jrmfrbg/7SegmentWattageCounterESP32/Altium_Data/high-24145_1280.png

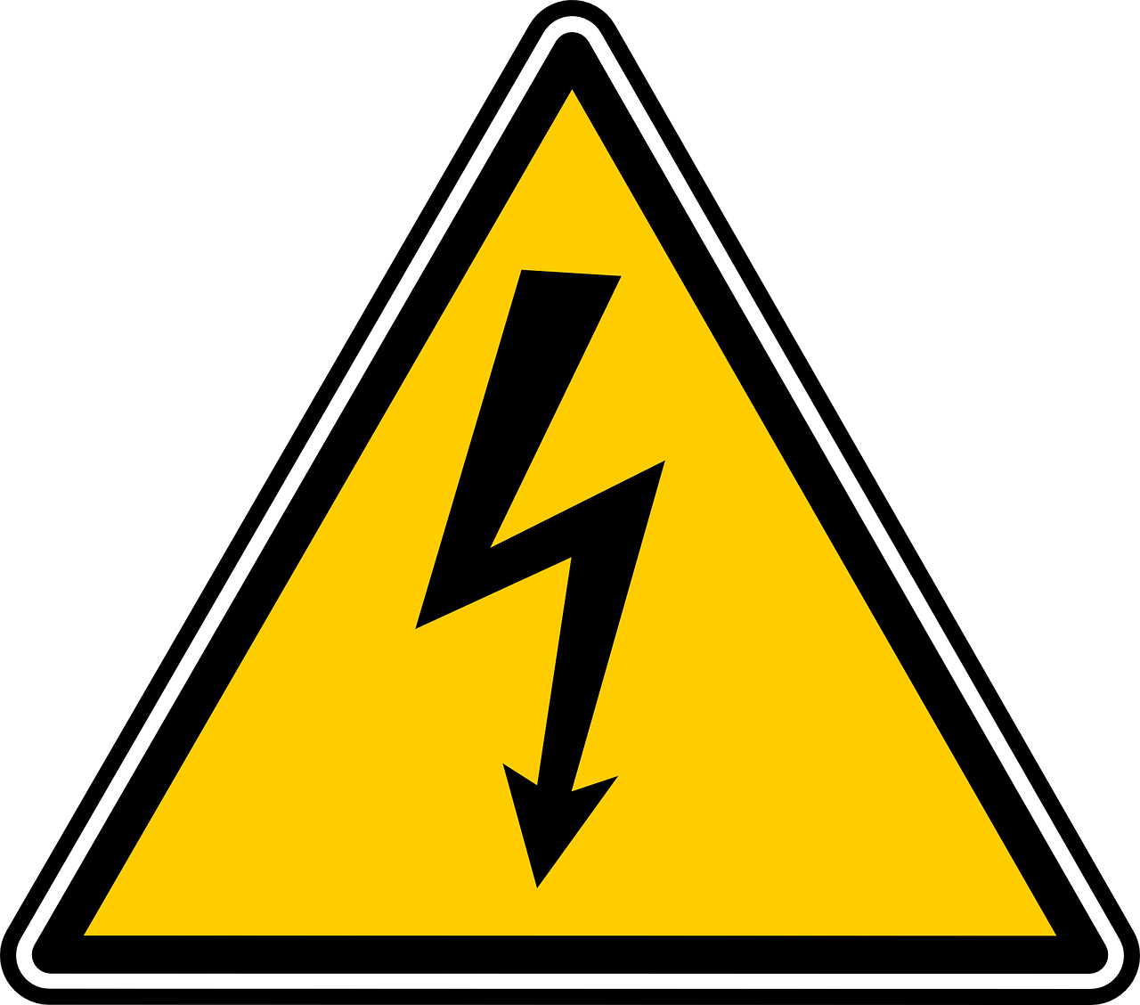
Altium_Data/high-24145_1280.png
