jrmfrbg/7SegmentWattageCounterESP32/Altium_Data/muempel8.bmp

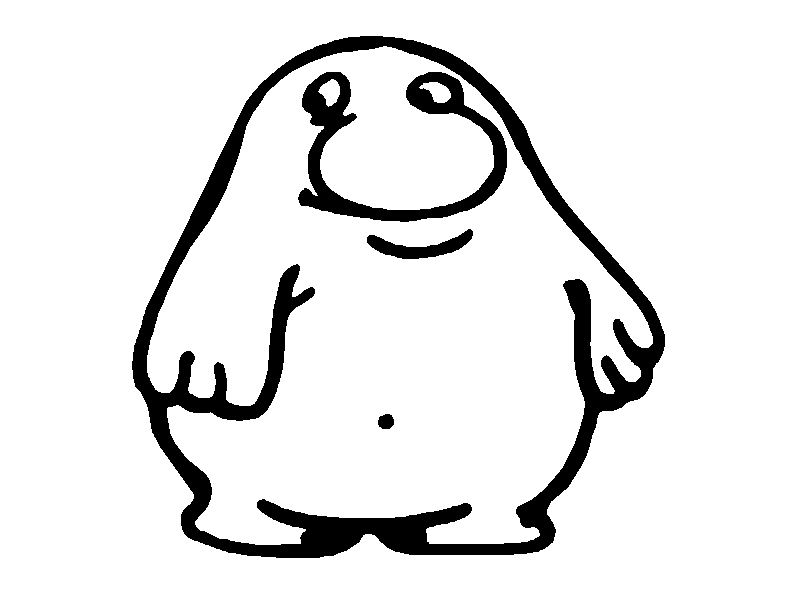
Altium_Data/muempel8.bmp
