jrmfrbg/7SegmentWattageCounterESP32/Altium_Data/Project Outputs for AC-Power-Monitor/AC-Power-Monitor.pdf

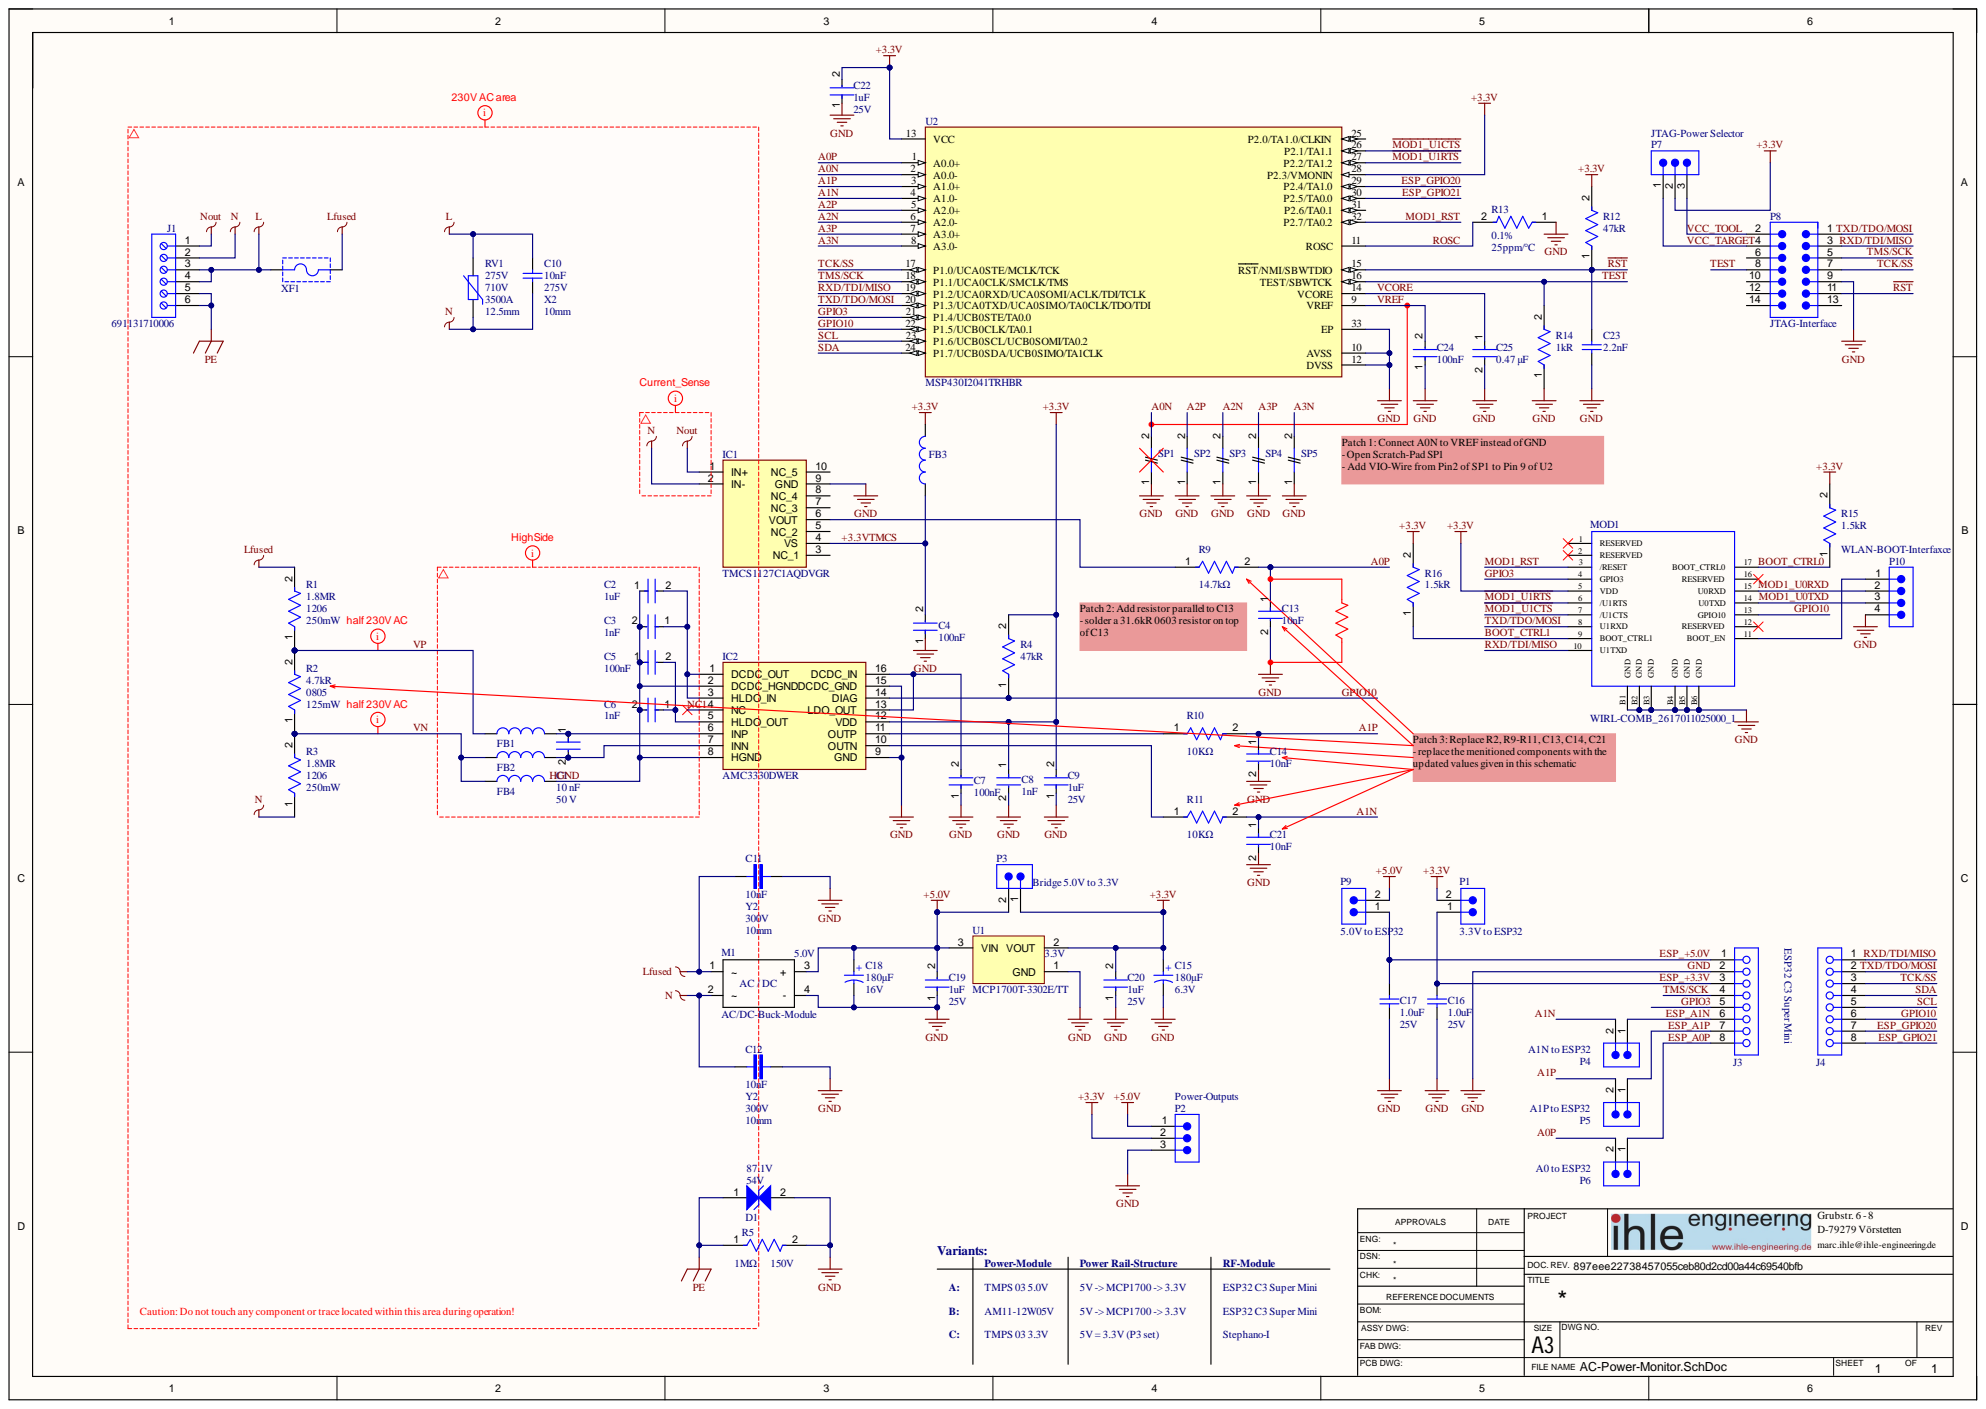
[picture p3: page 1]

Patch 1:Connect A0N to VREF instead ofGND
-Open Scratch-Pad SP1
- Add VIO-Wire from Pin2 of SP1 to Pin 9 of U2

+3.3VTMCS

MOD1_RST | RESERVED 2

Patch 2:Add resistor parallel to C13
-solder a 31.6kR 0603 resistor on top
ofC13

Patch 3:ReplaceR2, R9-R11, C13, C14, C21
-replace themenitioned components with the
updated values given in thisschematic

GND | 2
ESP_+3.3V | 3

TMS/SCK A1N | 4

AC/DC-Buck-Module

ESP_A1P | 7
ESP_A0P | 8

DATE | PROJECT APPROVALS | Grubstr. 6 - 8 D-79279 Vörstetten marc.ihle@ihle-engineering.de

ENG: *

DSN: *

Caution:Do not touch any component or trace located within this area during operation!

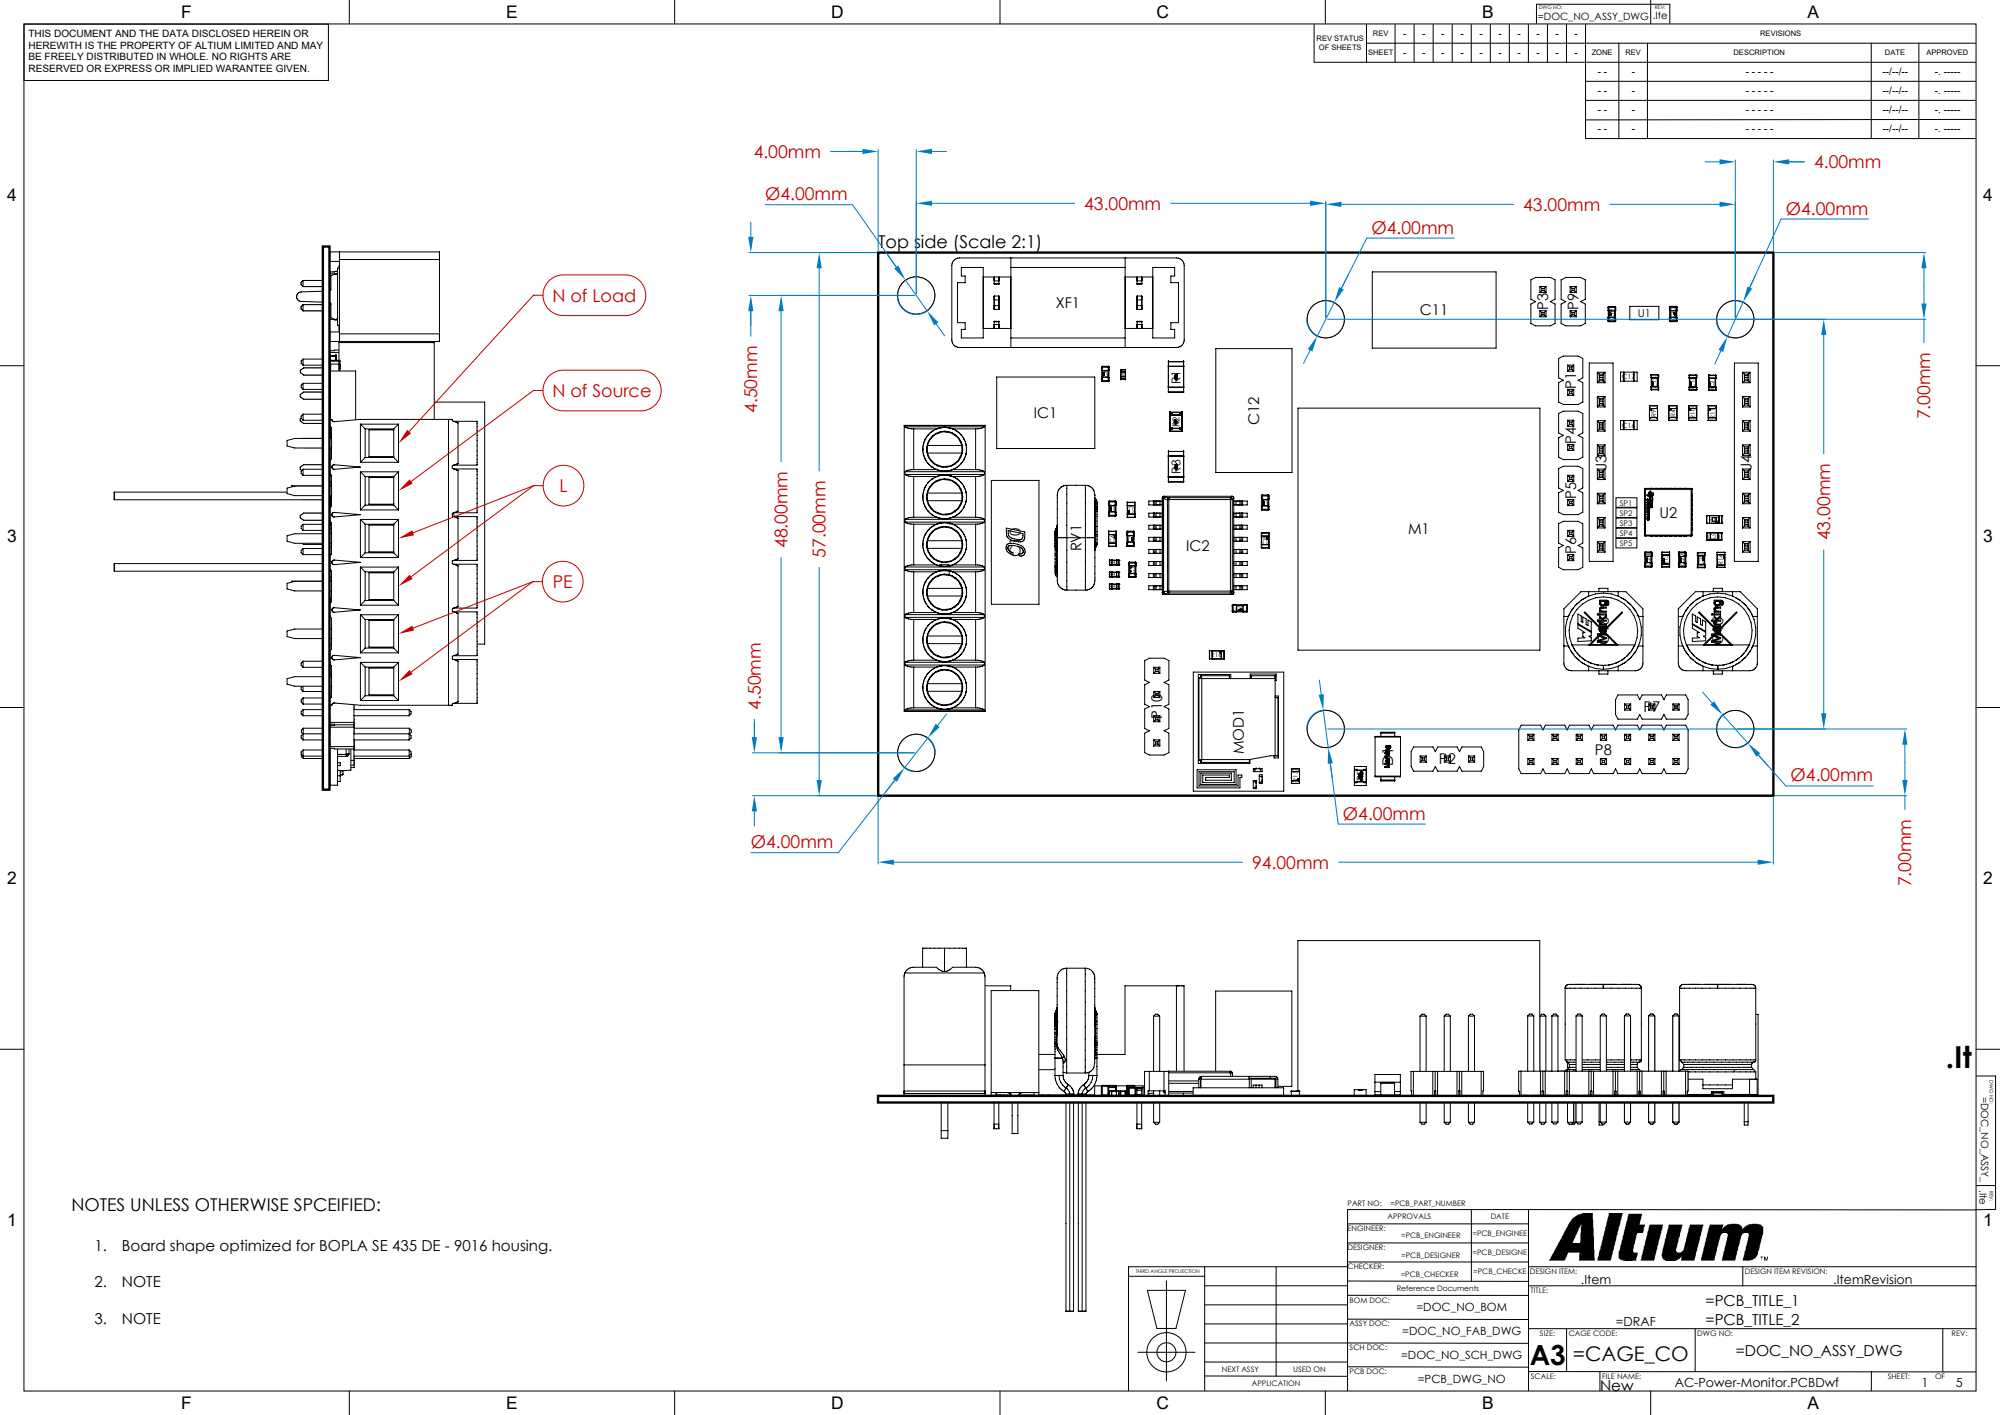
[picture p4: page 2]

THIS DOCUMENT AND THE DATA DISCLOSED HEREIN OR
HEREWITH IS THE PROPERTY OF ALTIUM LIMITED AND MAY
BE FREELY DISTRIBUTED IN WHOLE. NO RIGHTS ARE
RESERVED OR EXPRESS OR IMPLIED WARANTEE GIVEN.

NOTES UNLESS OTHERWISE SPCEIFIED:

APPROVALS | DATE

ENGINEER: =PCB_ENGINEER | =PCB_ENGINEE

1. Board shape optimized for BOPLA SE 435 DE - 9016 housing.

DESIGNER: =PCB_DESIGNER | =PCB_DESIGNE

THIRD ANGLE PROJECTION

CHECKER: =PCB_CHECKER | =PCB_CHECKE

SCH DOC: =DOC_NO_SCH_DWG

NEXT ASSY | USED ON

AC-Power-Monitor.PCBDwf

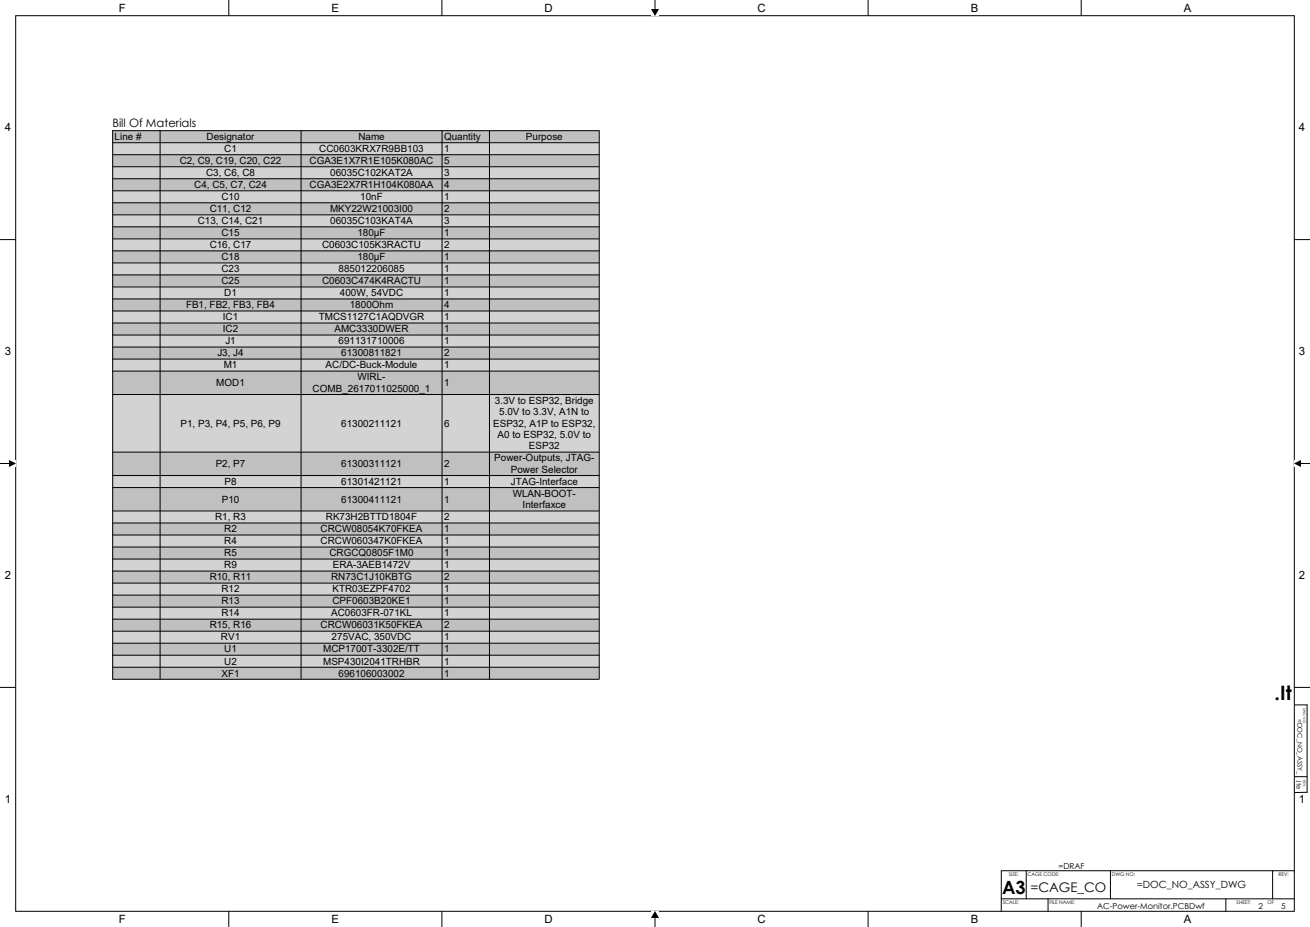
[picture p5: page 3]

Line # | Designator | Name | | Purpose

IC1 | TMCS1127C1AQDVGR | Quantity 15341231211114111211621121111211121111
C1 | CC0603KRX7R9BB103

C2, C9, C19, C20, C22 | CGA3E1X7R1E105K080AC
C3, C6, C8 | 06035C102KAT2A
C4, C5, C7, C24 | CGA3E2X7R1H104K080AA
C10 | 10nF
C11, C12 | MKY22W21003I00
C13, C14, C21 | 06035C103KAT4A
C15 | 180µF
C16, C17 | C0603C105K3RACTU
C18 | 180µF
C23 | 885012206085
C25 | C0603C474K4RACTU
D1 | 400W, 54VDC

FB1, FB2, FB3, FB4 | 1800Ohm

IC2 | AMC3330DWER
J1 | 691131710006
J3, J4 | 61300811821
M1 | AC/DC-Buck-Module
MOD1 | WIRL-COMB_2617011025000_1

P1, P3, P4, P5, P6, P9 | 61300211121 | | 3.3V to ESP32, Bridge 5.0V to 3.3V, A1N to ESP32, A1P to ESP32, A0 to ESP32, 5.0V to ESP32

P2, P7 | 61300311121 | | Power-Outputs, JTAG-Power Selector

P8 | 61301421121 | | JTAG-Interface
P10 | 61300411121 | | WLAN-BOOT-Interfaxce

R1, R3 | RK73H2BTTD1804F
R2 | CRCW08054K70FKEA
R4 | CRCW060347K0FKEA
R5 | CRGCQ0805F1M0
R9 | ERA-3AEB1472V
R10, R11 | RN73C1J10KBTG
R12 | KTR03EZPF4702
R13 | CPF0603B20KE1
R14 | AC0603FR-071KL
R15, R16 | CRCW06031K50FKEA
RV1 | 275VAC, 350VDC
U1 | MCP1700T-3302E/TT
U2 | MSP430I2041TRHBR
XF1 | 696106003002

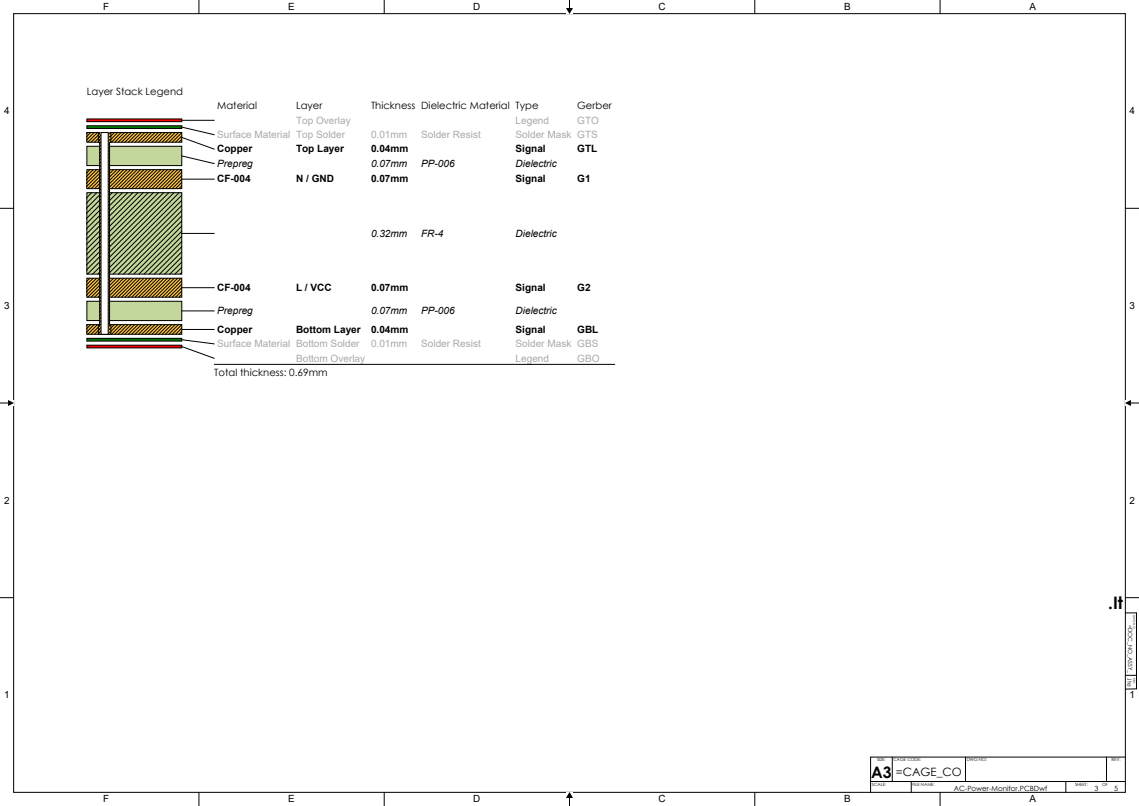
[picture p6: page 4]

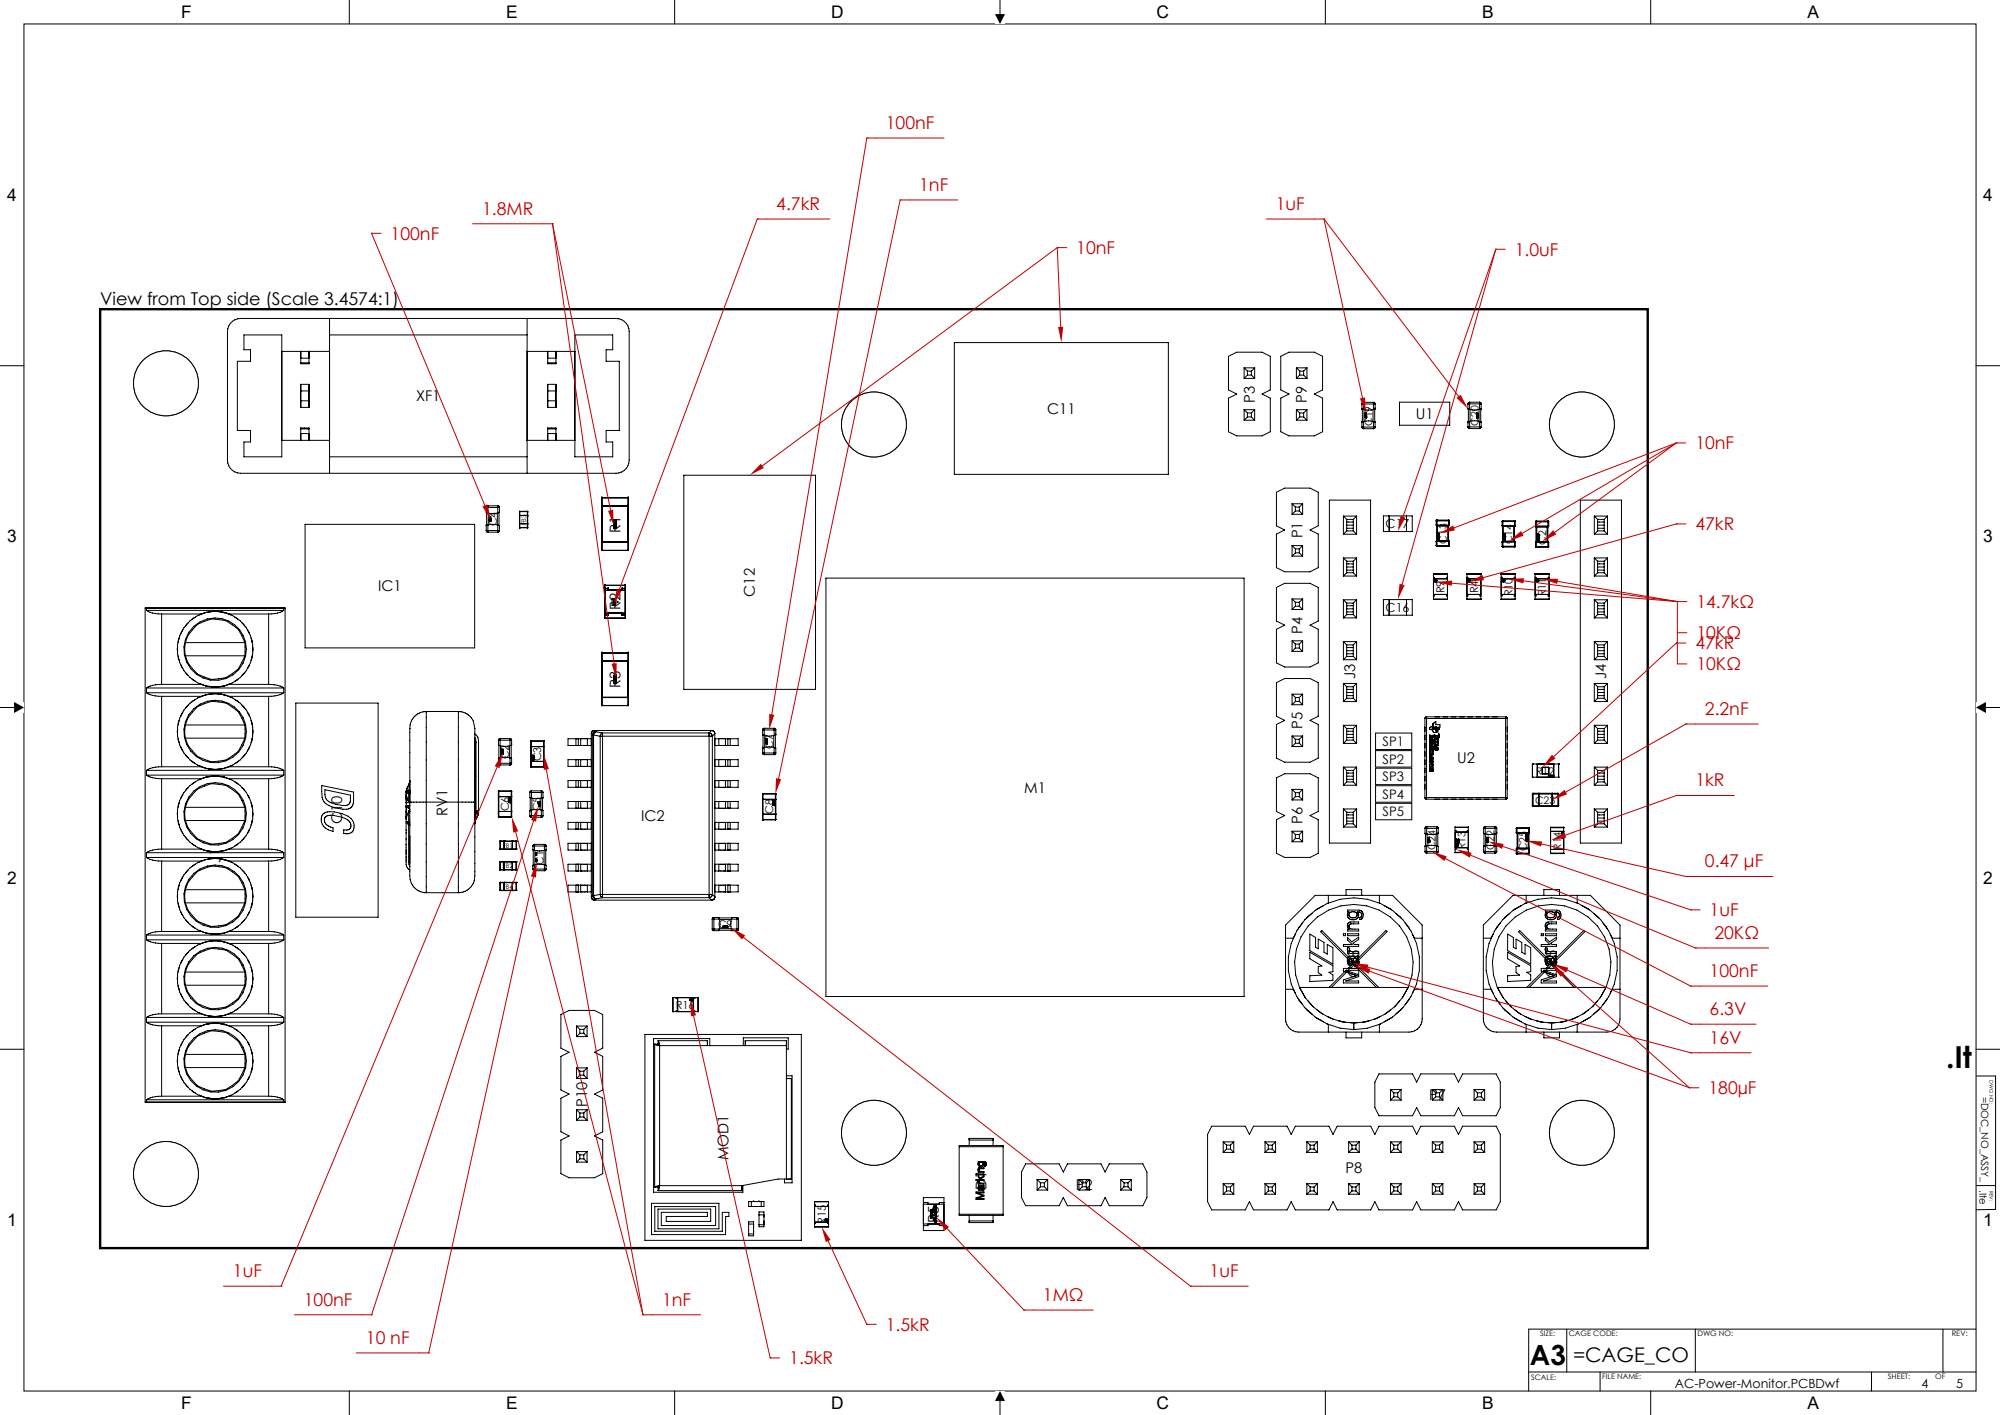
[picture p7: page 5]

View from Top side (Scale 3.4574:1)

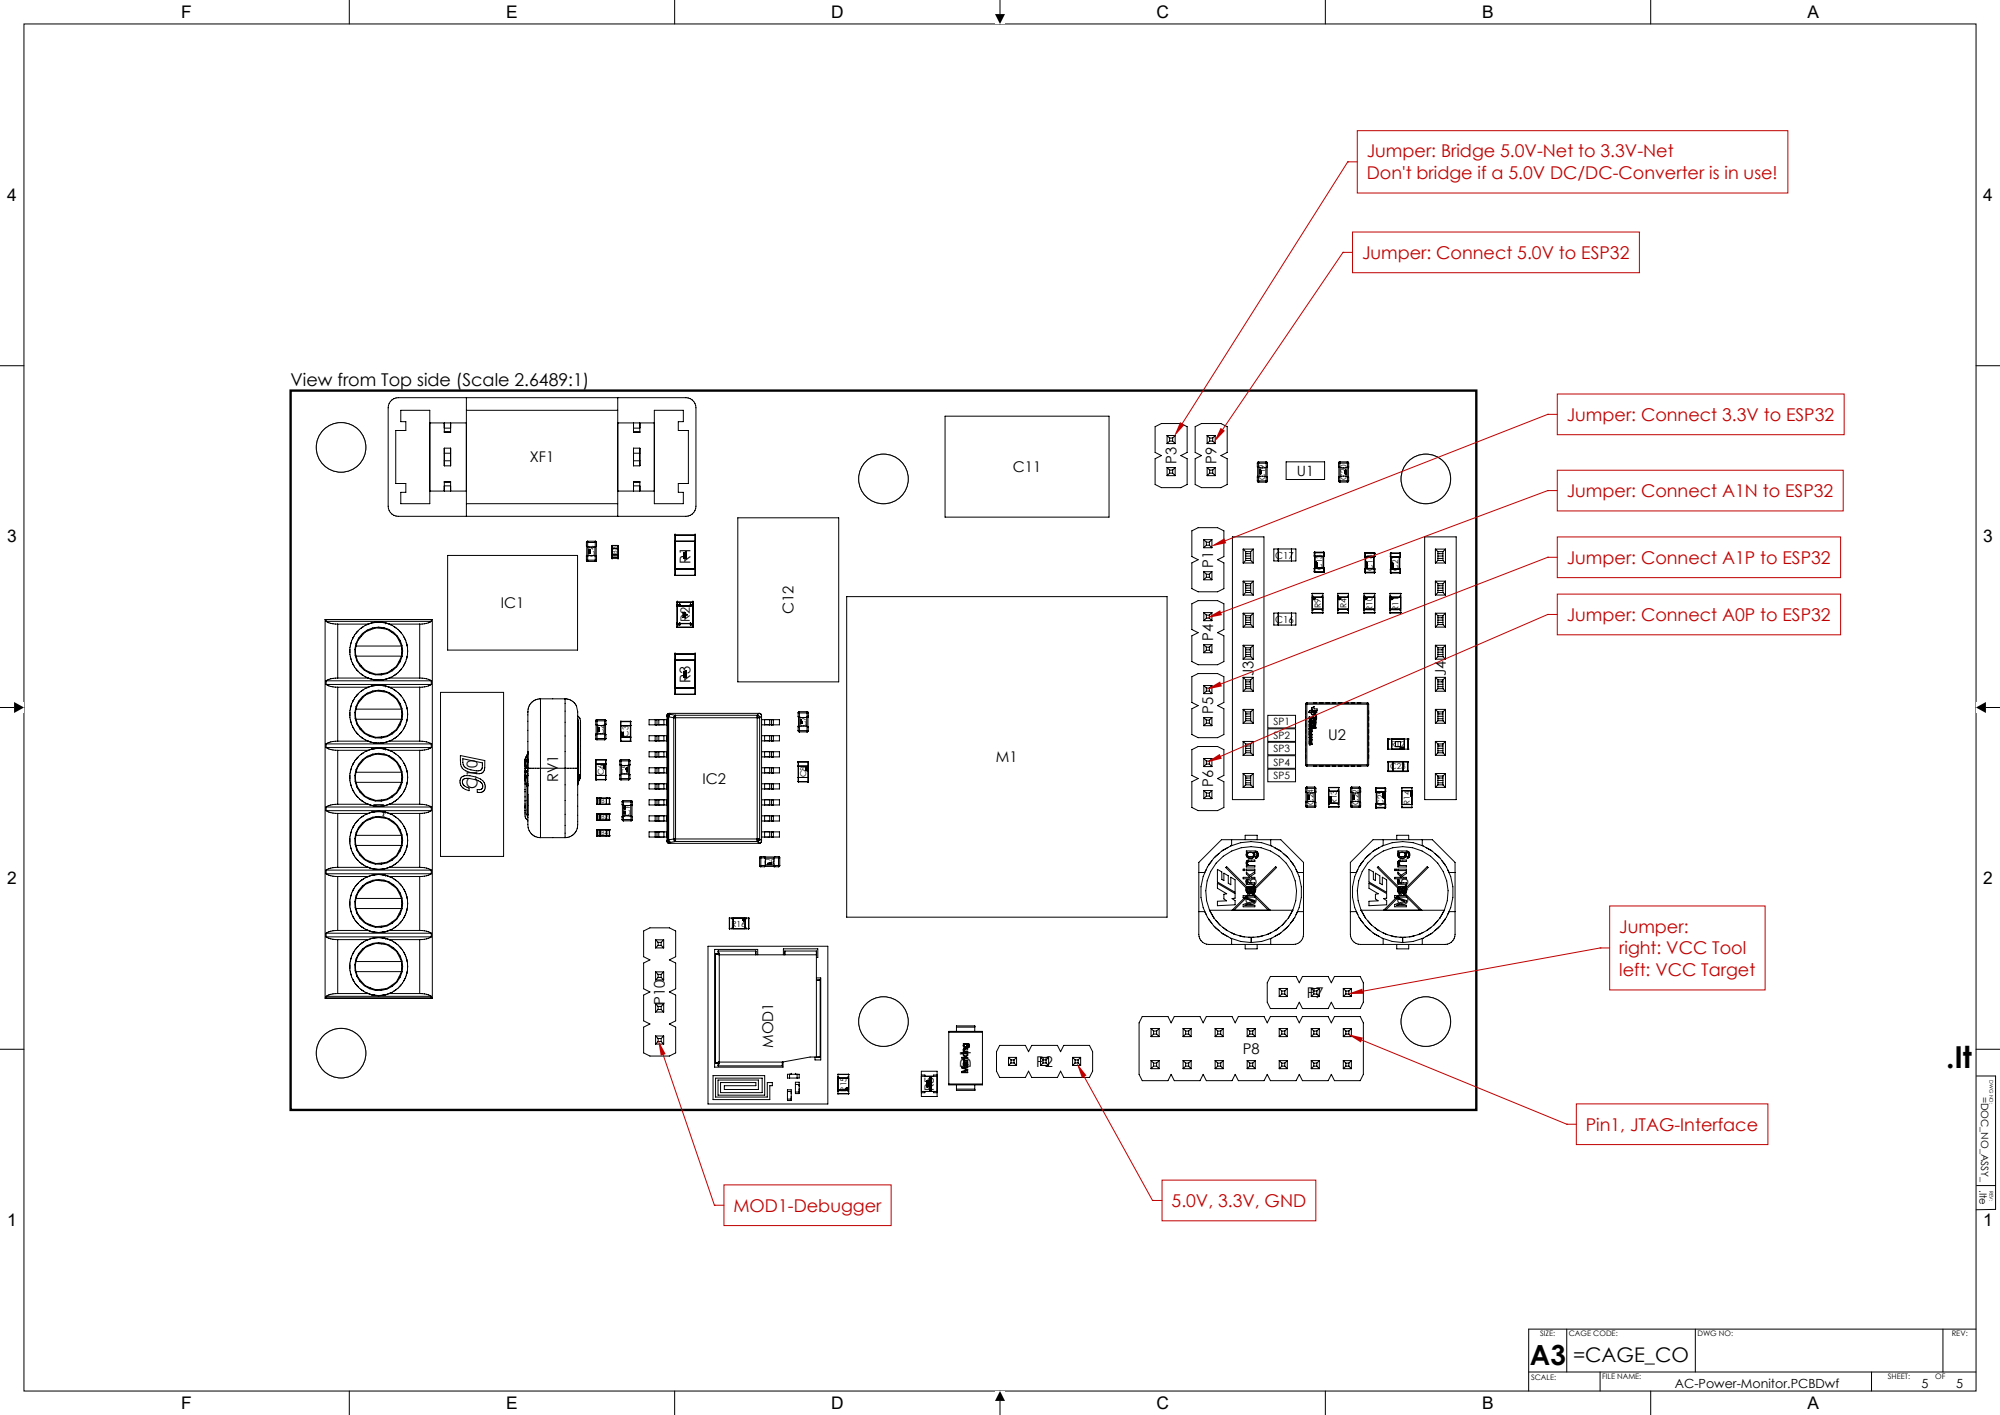
[picture p8: page 6]

Jumper: Bridge 5.0V-Net to 3.3V-Net
Don't bridge if a 5.0V DC/DC-Converter is in use!

View from Top side (Scale 2.6489:1)

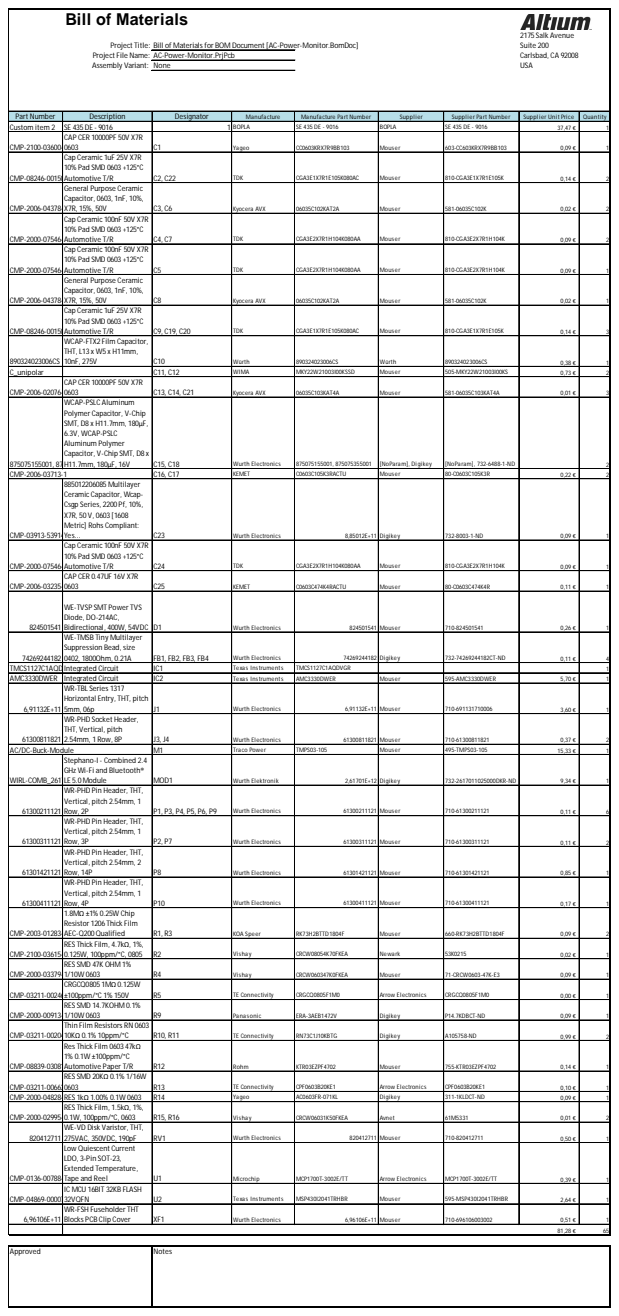
[picture p9: page 7]

Part Number | Description | Designator | Manufacture | Manufacture Part Number | Supplier | Supplier Part Number | Supplier Unit Price | Quantity
Custom item 2 | SE 435 DE - 9016 | 1 BOPLA | | SE 435 DE - 9016 | BOPLA | SE 435 DE - 9016 | 37,47 € | | 1
CMP-2100-03600- | CAP CER 10000PF 50V X7R 0603 | C1 | Yageo | CC0603KRX7R9BB103 | Mouser | 603-CC603KRX7R9BB103 | 0,09 € | | 1

CMP-08246-00150 | Cap Ceramic 1uF 25V X7R 10% Pad SMD 0603 +125°C Automotive T/R | C2, C22 | TDK | CGA3E1X7R1E105K080AC | Mouser | 810-CGA3E1X7R1E105K | 0,14 € | | 2

CMP-2006-04378- | General Purpose Ceramic Capacitor, 0603, 1nF, 10%, X7R, 15%, 50V | C3, C6 | Kyocera AVX | 06035C102KAT2A | Mouser | 581-06035C102K | 0,02 € | | 2

CMP-2000-07546- | Cap Ceramic 100nF 50V X7R 10% Pad SMD 0603 +125°C Automotive T/R | C4, C7 | TDK | CGA3E2X7R1H104K080AA | Mouser | 810-CGA3E2X7R1H104K | 0,09 € | | 2

CMP-2000-07546- | Cap Ceramic 100nF 50V X7R 10% Pad SMD 0603 +125°C Automotive T/R | C5 | TDK | CGA3E2X7R1H104K080AA | Mouser | 810-CGA3E2X7R1H104K | 0,09 € | | 1

CMP-2006-04378- | General Purpose Ceramic Capacitor, 0603, 1nF, 10%, X7R, 15%, 50V | C8 | Kyocera AVX | 06035C102KAT2A | Mouser | 581-06035C102K | 0,02 € | | 1

CMP-08246-00150 | Cap Ceramic 1uF 25V X7R 10% Pad SMD 0603 +125°C Automotive T/R | C9, C19, C20 | TDK | CGA3E1X7R1E105K080AC | Mouser | 810-CGA3E1X7R1E105K | 0,14 € | | 3

890324023006CS | WCAP-FTX2 Film Capacitor, THT, L13 x W5 x H11mm, 10nF, 275V | C10 | Würth | 890324023006CS | Würth | 890324023006CS | 0,38 € | | 1

C_unipolar | | C11, C12 | WIMA | MKY22W21003I00KSSD | Mouser | 505-MKY22W21003I00KS | 0,73 € | | 2
CMP-2006-02076- | CAP CER 10000PF 50V X7R 0603 | C13, C14, C21 | Kyocera AVX | 06035C103KAT4A | Mouser | 581-06035C103KAT4A | 0,01 € | | 3

875075155001, 87 | WCAP-PSLC Aluminum Polymer Capacitor, V-Chip SMT, D8 x H11.7mm, 180µF, 6.3V, WCAP-PSLC Aluminum Polymer Capacitor, V-Chip SMT, D8 x H11.7mm, 180µF, 16V | C15, C18 | Wurth Electronics | 875075155001, 875075355001 | [NoParam], Digikey | [NoParam], 732-6488-1-ND | | | 2

CMP-2006-03713-1 | | C16, C17 | KEMET | C0603C105K3RACTU | Mouser | 80-C0603C105K3R | 0,22 € | | 2
CMP-03913-53914 | 885012206085 Multilayer Ceramic Capacitor, Wcap-Csgp Series, 2200 Pf, 10%, X7R, 50 V, 0603 [1608 Metric] Rohs Compliant: Yes... | C23 | Wurth Electronics | 8,85012E+11 | Digikey | 732-8003-1-ND | 0,09 € | | 1

CMP-2000-07546- | Cap Ceramic 100nF 50V X7R 10% Pad SMD 0603 +125°C Automotive T/R | C24 | TDK | CGA3E2X7R1H104K080AA | Mouser | 810-CGA3E2X7R1H104K | 0,09 € | | 1

CMP-2006-03235- | CAP CER 0.47UF 16V X7R 0603 | C25 | KEMET | C0603C474K4RACTU | Mouser | 80-C0603C474K4R | 0,11 € | | 1

824501541 | WE-TVSP SMT Power TVS Diode, DO-214AC, Bidirectional, 400W, 54VDC | D1 | Wurth Electronics | 824501541 | Mouser | 710-824501541 | 0,26 € | | 1

74269244182 | WE-TMSB Tiny Multilayer Suppression Bead, size 0402, 1800Ohm, 0.21A | FB1, FB2, FB3, FB4 | Wurth Electronics | 74269244182 | Digikey | 732-74269244182CT-ND | 0,11 € | | 4

TMCS1127C1AQDInte grated Circuit | | IC1 | Texas Instruments | TMCS1127C1AQDVGR | | | | | 1
AMC3330DWER | Integrated Circuit | IC2 | Texas Instruments | AMC3330DWER | Mouser | 595-AMC3330DWER | 5,70 € | | 1
6,91132E+11 | WR-TBL Series 1317 Horizontal Entry, THT, pitch 5mm, 06p | J1 | Wurth Electronics | 6,91132E+11 | Mouser | 710-691131710006 | 3,60 € | | 1

61300811821 | WR-PHD Socket Header, THT, Vertical, pitch 2.54mm, 1 Row, 8P | J3, J4 | Wurth Electronics | 61300811821 | Mouser | 710-61300811821 | 0,37 € | | 2

AC/DC-Buck-Module | | M1 | Traco Power | TMPS03-105 | Mouser | 495-TMPS03-105 | 15,33 € | | 1
WIRL-COMB_2617 | Stephano-I - Combined 2.4 GHz Wi-Fi and Bluetooth® LE 5.0 Module | MOD1 | Wurth Elektronik | 2,61701E+12 | Digikey | 732-2617011025000DKR-ND | 9,34 € | | 1

61300211121 | WR-PHD Pin Header, THT, Vertical, pitch 2.54mm, 1 Row, 2P | P1, P3, P4, P5, P6, P9 | Wurth Electronics | 61300211121 | Mouser | 710-61300211121 | 0,11 € | | 6

61300311121 | WR-PHD Pin Header, THT, Vertical, pitch 2.54mm, 1 Row, 3P | P2, P7 | Wurth Electronics | 61300311121 | Mouser | 710-61300311121 | 0,11 € | | 2

61301421121 | WR-PHD Pin Header, THT, Vertical, pitch 2.54mm, 2 Row, 14P | P8 | Wurth Electronics | 61301421121 | Mouser | 710-61301421121 | 0,85 € | | 1

61300411121 | WR-PHD Pin Header, THT, Vertical, pitch 2.54mm, 1 Row, 4P | P10 | Wurth Electronics | 61300411121 | Mouser | 710-61300411121 | 0,17 € | | 1

CMP-2003-01283- | 1.8MΩ ±1% 0.25W Chip Resistor 1206 Thick Film AEC-Q200Qualified | R1, R3 | KOA Speer | RK73H2BTTD1804F | Mouser | 660-RK73H2BTTD1804F | 0,09 € | | 2

CMP-2100-03615- | RES Thick Film, 4.7kΩ, 1%, 0.125W, 100ppm/°C, 0805 | R2 | Vishay | CRCW08054K70FKEA | Newark | 53K0215 | 0,02 € | | 1

CMP-2000-03379- | RES SMD 47K OHM 1% 1/10W 0603 | R4 | Vishay | CRCW060347K0FKEA | Mouser | 71-CRCW0603-47K-E3 | 0,09 € | | 1

CMP-03211-00246 | CRGCQ0805 1MΩ 0.125W ±100ppm/°C 1% 150V | R5 | TE Connectivity | CRGCQ0805F1M0 | Arrow Electronics | CRGCQ0805F1M0 | 0,00 € | | 1

CMP-2000-00913- | RES SMD 14.7KOHM 0.1% 1/10W 0603 | R9 | Panasonic | ERA-3AEB1472V | Digikey | P14.7KDBCT-ND | 0,09 € | | 1

CMP-03211-00204 | Thin Film Resistors RN 0603 10KΩ 0.1% 10ppm/°C | R10, R11 | TE Connectivity | RN73C1J10KBTG | Digikey | A105758-ND | 0,99 € | | 2

CMP-08839-03081 | Res Thick Film 0603 47kΩ 1% 0.1W ±100ppm/°C Automotive Paper T/R | R12 | Rohm | KTR03EZPF4702 | Mouser | 755-KTR03EZPF4702 | 0,14 € | | 1

CMP-03211-00663 | RES SMD 20KΩ 0.1% 1/16W 0603 | R13 | TE Connectivity | CPF0603B20KE1 | Arrow Electronics | CPF0603B20KE1 | 0,10 € | | 1

CMP-2000-04828-RES 1kΩ 1.00% 0.1W 0603 | | R14 | Yageo | AC0603FR-071KL | Digikey | 311-1KLDCT-ND | 0,09 € | | 1
CMP-2000-02995- | RES Thick Film, 1.5kΩ, 1%, 0.1W, 100ppm/°C, 0603 | R15, R16 | Vishay | CRCW06031K50FKEA | Avnet | 61M5331 | 0,01 € | | 2

820412711 | WE-VD Disk Varistor, THT, 275VAC, 350VDC, 190pF | RV1 | Wurth Electronics | 820412711 | Mouser | 710-820412711 | 0,50 € | | 1

CMP-0136-00788- | Low Quiescent Current LDO, 3-Pin SOT-23, Extended Temperature, Tape and Reel | U1 | Microchip | MCP1700T-3002E/TT | Arrow Electronics | MCP1700T-3002E/TT | 0,39 € | | 1

CMP-04869-00007 | IC MCU 16BIT 32KB FLASH 32VQFN | U2 | Texas Instruments | MSP430I2041TRHBR | Mouser | 595-MSP430I2041TRHBR | 2,64 € | | 1

6,96106E+11 | WR-FSH Fuseholder THT Blocks PCB Clip Cover | XF1 | Wurth Electronics | 6,96106E+11 | Mouser | 710-696106003002 | 0,51 € | | 1
