jrmfrbg/7SegmentWattageCounterESP32/Master/Master/AC-Power-Monitor.pdf

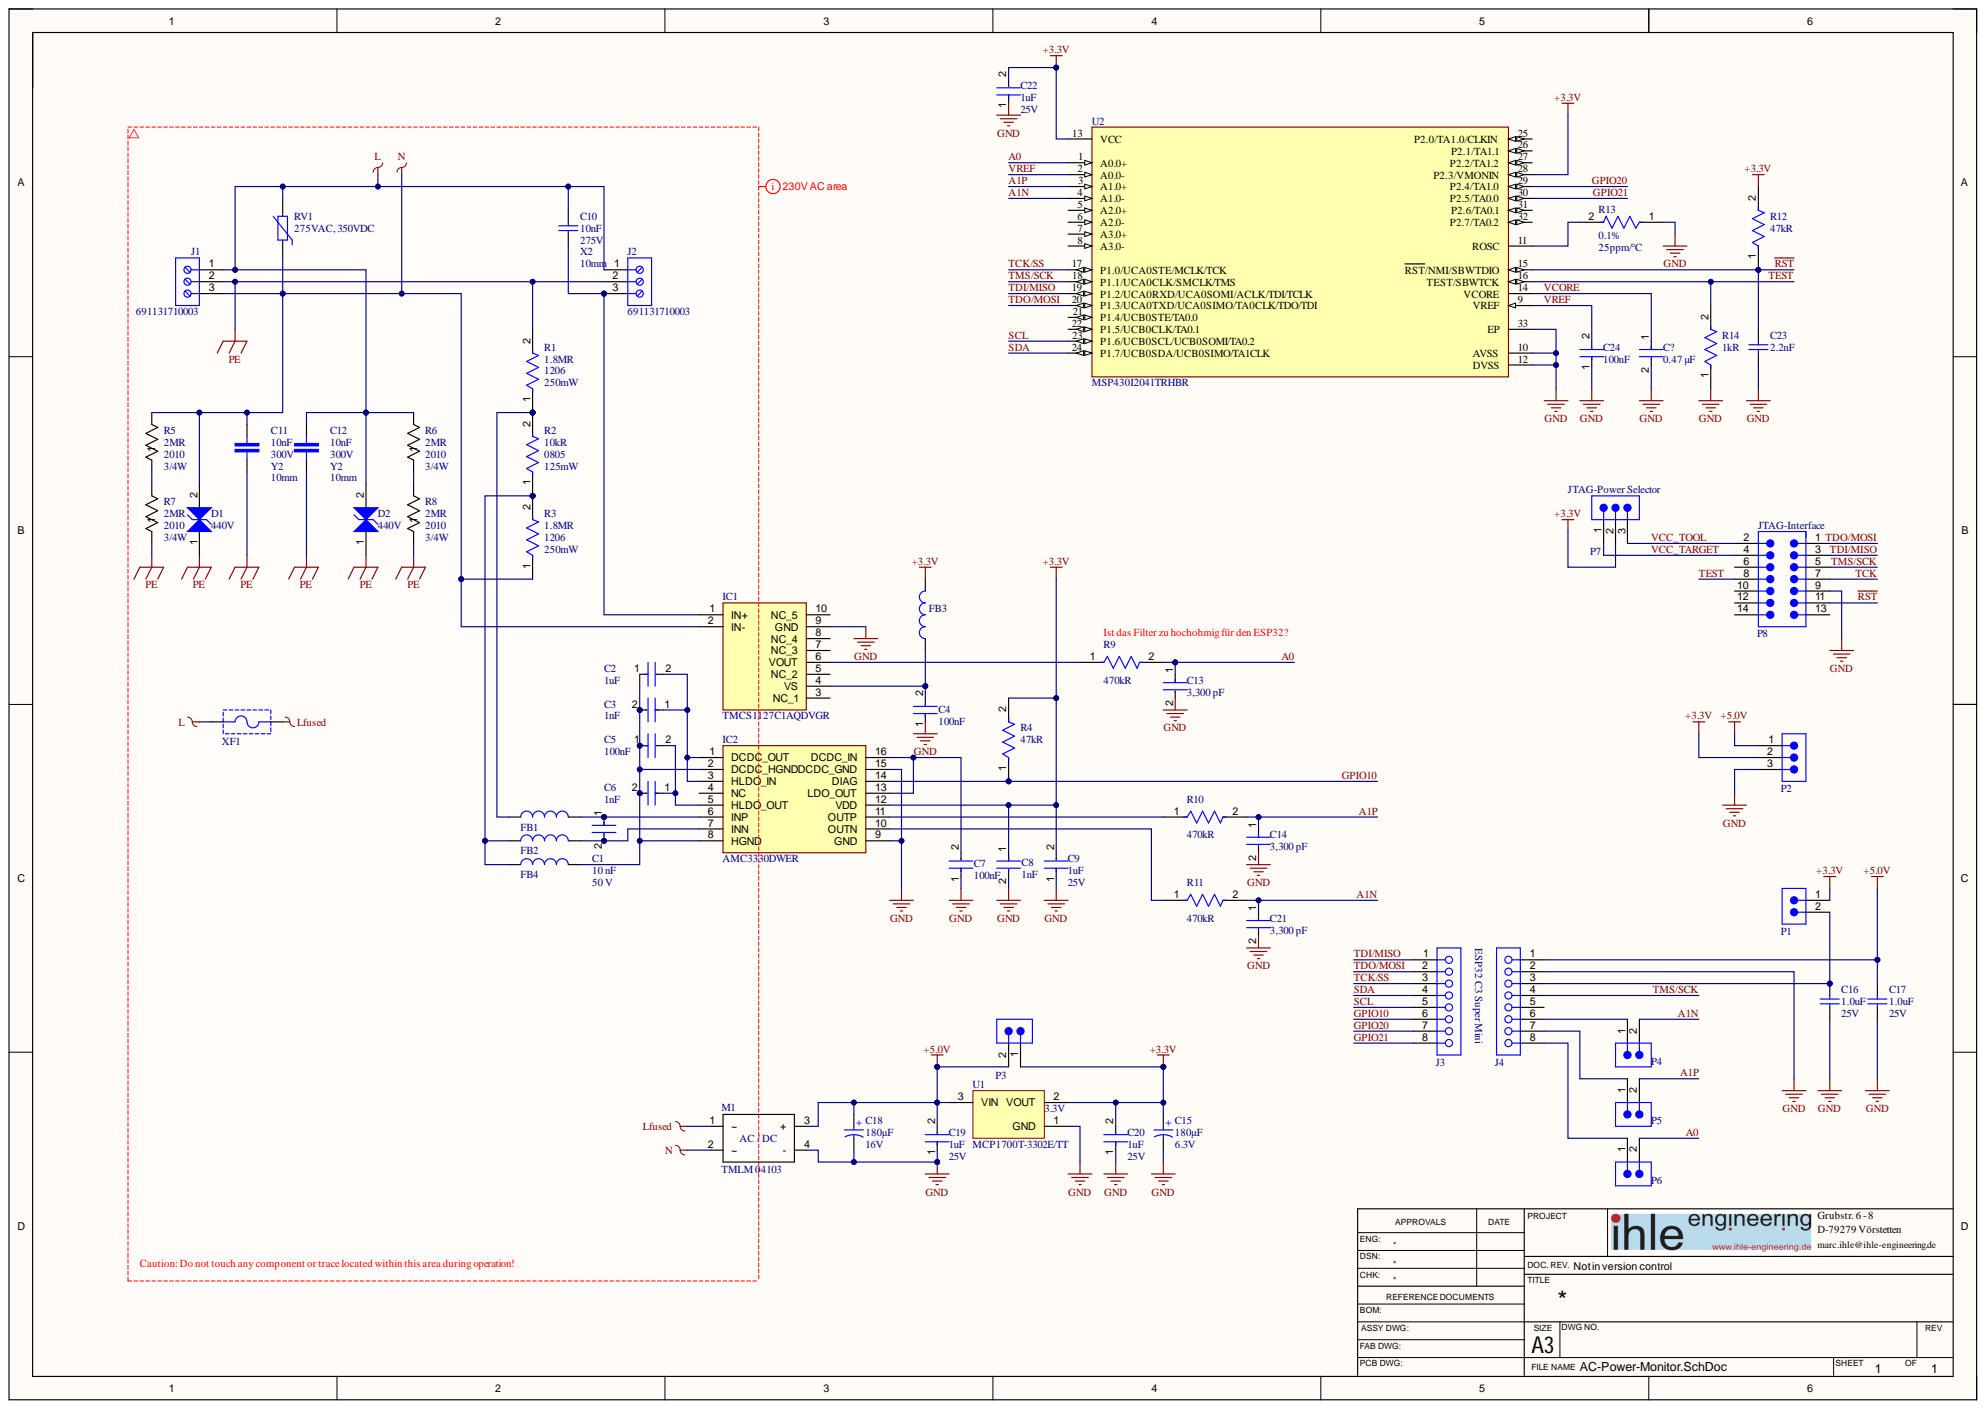
[picture p10: page 1]
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

EN G :
** DSN :

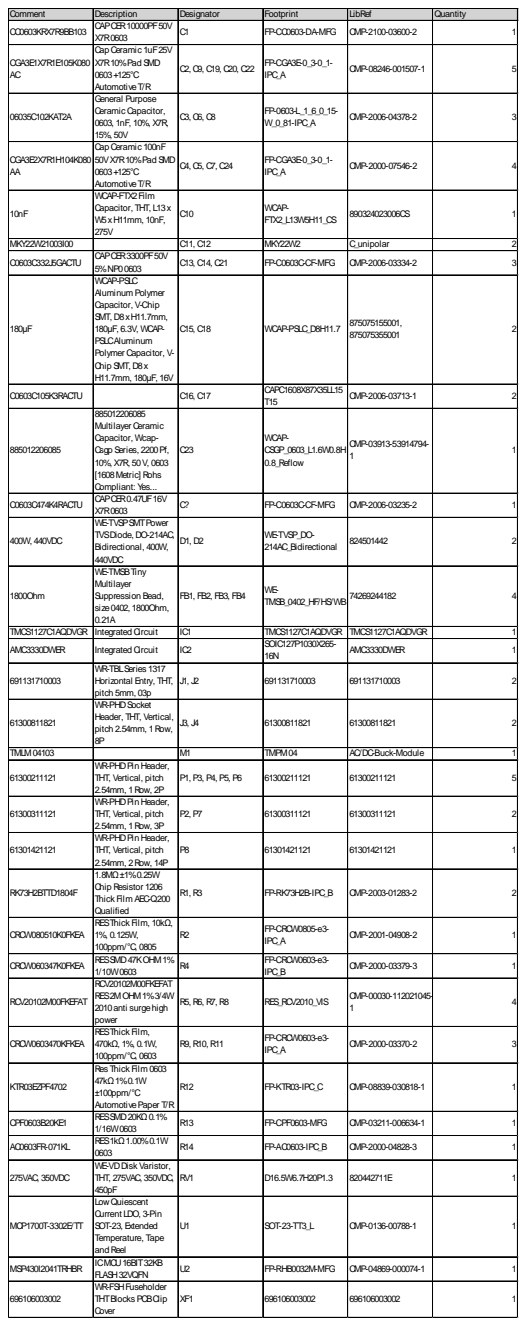
[picture p11: page 2]

Comment | Description | Designator | Footprint | LibRef | Quantity
CC0603KRX7R9BB103 | CAPCER10000PF50V X7R0603 | C1 | FP-CC0603-DA-MFG | CMP-2100-03600-2 | 1

CGA3E1X7R1E105K080 AC | Cap Ceramic 1uF25V X7R10%Pad SMD 0603+125°C AutomotiveT/R | C2, C9, C19, C20, C22 | FP-CGA3E-0_3-0_1-IPC_A | CMP-08246-001507-1 | 5

06035C102KAT2A | General Purpose Ceramic Capacitor, 0603, 1nF, 10%, X7R, 15%, 50V | C3, C6, C8 | FP-0603-L_1_6_0_15-W_0_81-IPC_A | CMP-2006-04378-2 | 3

CGA3E2X7R1H104K080 AA | Cap Ceramic 100nF 50VX7R10%Pad SMD 0603+125°C AutomotiveT/R | C4, C5, C7, C24 | FP-CGA3E-0_3-0_1-IPC_A | CMP-2000-07546-2 | 4

10nF | WCAP-FTX2Film Capacitor, THT, L13x W5xH11mm, 10nF, 275V | C10 | WCAP-FTX2_L13W5H11_CS | 890324023006CS | 1

MKY22W21003I00 | | C11, C12 | MKY22W2 | C_unipolar | 2
C0603C332J5GACTU | CAPCER3300PF50V 5%NP00603 | C13, C14, C21 | FP-C0603C-CF-MFG | CMP-2006-03334-2 | 3

180µF | WCAP-PSLC Aluminum Polymer Capacitor, V-Chip SMT, D8xH11.7mm, 180µF, 6.3V, WCAP-PSLCAluminum Polymer Capacitor, V-Chip SMT, D8x H11.7mm, 180µF, 16V | C15, C18 | WCAP-PSLC_D8H11.7 | 875075155001, 875075355001 | 2

C0603C105K3RACTU | | C16, C17 | CAPC1608X87X35LL15 T15 | CMP-2006-03713-1 | 2

885012206085 | 885012206085 Multilayer Ceramic Capacitor, Wcap-Csgp Series, 2200Pf, 10%, X7R, 50V, 0603 [1608Metric] Rohs Compliant: Yes... | C23 | WCAP-CSGP_0603_L1.6W0.8H 0.8_Reflow | CMP-03913-53914794-1 | 1

C0603C474K4RACTU | CAPCER0.47UF16V X7R0603 | C? | FP-C0603C-CF-MFG | CMP-2006-03235-2 | 1

400W, 440VDC | WE-TVSPSMTPower TVSDiode, DO-214AC, Bidirectional, 400W, 440VDC | D1, D2 | WE-TVSP_DO-214AC_Bidirectional | 824501442 | 2

1800Ohm | WE-TMSBTiny Multilayer Suppression Bead, size0402, 1800Ohm, 0.21A | FB1, FB2, FB3, FB4 | WE-TMSB_0402_HF/HS/WB | 74269244182 | 4

TMCS1127C1AQDVGR | Integrated Circuit | IC1 | TMCS1127C1AQDVGR | TMCS1127C1AQDVGR | 1
AMC3330DWER | Integrated Circuit | IC2 | SOIC127P1030X265-16N | AMC3330DWER | 1

691131710003 | WR-TBLSeries 1317 Horizontal Entry, THT, pitch 5mm, 03p | J1, J2 | 691131710003 | 691131710003 | 2

61300811821 | WR-PHDSocket Header, THT, Vertical, pitch 2.54mm, 1Row, 8P | J3, J4 | 61300811821 | 61300811821 | 2

TMLM04103 | | M1 | TMPM04 | AC/DC-Buck-Module | 1
61300211121 | WR-PHDPin Header, THT, Vertical, pitch 2.54mm, 1Row, 2P | P1, P3, P4, P5, P6 | 61300211121 | 61300211121 | 5

61300311121 | WR-PHDPin Header, THT, Vertical, pitch 2.54mm, 1Row, 3P | P2, P7 | 61300311121 | 61300311121 | 2

61301421121 | WR-PHDPin Header, THT, Vertical, pitch 2.54mm, 2Row, 14P | P8 | 61301421121 | 61301421121 | 1

RK73H2BTTD1804F | 1.8MΩ±1%0.25W Chip Resistor 1206 Thick Film AEC-Q200 Qualified | R1, R3 | FP-RK73H2B-IPC_B | CMP-2003-01283-2 | 2

CRCW080510K0FKEA | RESThick Film, 10kΩ, 1%, 0.125W, 100ppm/°C, 0805 | R2 | FP-CRCW0805-e3-IPC_A | CMP-2001-04908-2 | 1

CRCW060347K0FKEA | RESSMD47KOHM1% 1/10W0603 | R4 | FP-CRCW0603-e3-IPC_B | CMP-2000-03379-3 | 1

RCV20102M00FKEFAT | RCV20102M00FKEFAT RES2MOHM1%3/4W 2010anti surgehigh power | R5, R6, R7, R8 | RES_RCV2010_VIS | CMP-00030-112021045-1 | 4

CRCW0603470KFKEA | RESThick Film, 470kΩ, 1%, 0.1W, 100ppm/°C, 0603 | R9, R10, R11 | FP-CRCW0603-e3-IPC_A | CMP-2000-03370-2 | 3

KTR03EZPF4702 | Res Thick Film 0603 47kΩ1%0.1W ±100ppm/°C AutomotivePaper T/R | R12 | FP-KTR03-IPC_C | CMP-08839-030818-1 | 1

CPF0603B20KE1 | RESSMD20KΩ0.1% 1/16W0603 | R13 | FP-CPF0603-MFG | CMP-03211-006634-1 | 1

AC0603FR-071KL | RES1kΩ1.00%0.1W 0603 | R14 | FP-AC0603-IPC_B | CMP-2000-04828-3 | 1

275VAC, 350VDC | WE-VDDiskVaristor, THT, 275VAC, 350VDC, 450pF | RV1 | D16.5W6.7H20P1.3 | 820442711E | 1

MCP1700T-3302E/TT | LowQuiescent Current LDO, 3-Pin SOT-23, Extended Temperature, Tape and Reel | U1 | SOT-23-TT3_L | CMP-0136-00788-1 | 1

MSP430I2041TRHBR | ICMCU16BIT32KB FLASH32VQFN | U2 | FP-RHB0032M-MFG | CMP-04869-000074-1 | 1

696106003002 | WR-FSHFuseholder THTBlocksPCBClip Cover | XF1 | 696106003002 | 696106003002 | 1
