jrmfrbg/7SegmentWattageCounterESP32/(list of files, drawings)

Other design files:
Altium_Data/AC-Power-Monitor.PcbDoc
Altium_Data/AC-Power-Monitor.PrjPcb
Altium_Data/AC-Power-Monitor.SchDoc
