jrmfrbg/7SegmentWattageCounterESP32/MSP430_software/main.c

#include <msp430.h> 
#include <Config_Common.h>

#include <stdbool.h>
#include <stdint.h>
#include <HAL.h>
#include <QmathLib.h>
#include <math.h>
#include "eusci_b_spi.h"
#include "GPIO.h"
#include "CS.h"
#include "IO_functions.h"
#include "hann_window.h"

// # defines for application code
#define STR_LEN_ONE      1

// Global variables
volatile uint8_t  command, adcChannel, adcA0Preload, adcA1Preload, adcA0Gain, adcA1Gain, adcReady;
volatile int32_t adcA0Data, adcA1Data;

// Power Measurement defines
#define INV_MEASUREMENT_COUNT (1/(float)MEASUREMENT_COUNT)

// scaling factor to calibrate voltage measurements:
//#define VSCALE 0.000043784       // factor for device #0001
#define VSCALE 0.000043444       // factor for device #0002
//#define VSCALE 0.000043712       // factor for device #0003
//#define VSCALE 0.000043608       // factor for device #0004
//#define VSCALE 0.000043373       // factor for device #0005

// scaling factor to calibrate current measurements:
//#define ISCALE 0.0000029976       // factor for device #0001
#define ISCALE 0.0000029838       // factor for device #0002
//#define ISCALE 0.0000029896       // factor for device #0003
//#define ISCALE 0.0000029786       // factor for device #0004
//#define ISCALE 0.0000029815       // factor for device #0005

#define PRMSMIN 0.5              // Power threshold: below this power, the current noise value may be increased
#define IMS0INITVALUE 20000000   // Rough estimation of squared current noise level
#define IMS0SCALER 1.05          // scaling factor to reduce measurement of current noise
#define TXTLENGTH 80             // maximum number of characters allowed for the TXData buffer

int64_t  Vms, Ims, Pms, Vdc, Idc;     // variables to sum up sample values; ms: sum of squared or multiplied values

const float win[MEASUREMENT_COUNT];

float Vrms, Irms, Prms, VArms, tmpfloat;
uint32_t Ims0;

uint16_t n;
int64_t  voltage, current;

char TXData[TXTLENGTH];
volatile uint8_t TXcount = 0;
volatile char* TXpointer;
//volatile uint8_t* TXpointer;
uint8_t RXData = 0;


// Main
void main(void)
{


    EUSCI_B_SPI_initMasterParam spiMasterConfig =
     {
         EUSCI_B_SPI_CLOCKSOURCE_ACLK,              // ACLK Clock Source
         32000,                                     // ACLK = 32kHz
         16000,                                     // SPICLK = 16kHz
         EUSCI_B_SPI_MSB_FIRST,                     // MSB First
         EUSCI_B_SPI_PHASE_DATA_CHANGED_ONFIRST_CAPTURED_ON_NEXT,    // Phase
         EUSCI_B_SPI_CLOCKPOLARITY_INACTIVITY_HIGH, // High polarity
         EUSCI_B_SPI_4PIN_UCxSTE_ACTIVE_LOW        // 4Wire SPI Mode
     };

    UCB0CTLW0 |= UCSTEM;

    WDTCTL = WDTPW | WDTHOLD;                       // Stop WDT

    // Initialize clocks, GPIOs
    HAL_System_Init();

    Ims0 = IMS0INITVALUE;  // set initial value


    // Setting P1.5, P1.6 and P1.7 as SPI pins.
    GPIO_setAsPeripheralModuleFunctionInputPin(GPIO_PORT_P1,
            GPIO_PIN5 | GPIO_PIN6 | GPIO_PIN7,
            GPIO_PRIMARY_MODULE_FUNCTION);

    // SPI CS Pin
    P1DIR |= GPIO_PIN4;  // set P1.4 (GPIO3) as output
    P1OUT |= GPIO_PIN4; //  set P1.4 (GPIO3) to H

    // Setting the DCO to use the internal resistor. DCO will be at 16.384MHz
    // ACLK is at 32kHz
    CS_setupDCO(CS_INTERNAL_RESISTOR);

if (1==0)
{
// copy some FLASH-code to RAM
//    char* ptr = (char *)__segment_begin("FLASH_EXECUTE");
//    char* ram = (char *)__segment_begin("RAM_EXECUTE");
    char* ptr = (char *)0x00008000;
    char* ram = (char *)0x00000200;
    uint16_t counter = 0;
    while(counter++ < 0x600)
    {
        *ram = *ptr ;
        ptr++ ;
        ram++ ;
    }
}

    // Configure and enable the SPI peripheral
    EUSCI_B_SPI_initMaster(EUSCI_B0_BASE, &spiMasterConfig);
    EUSCI_B_SPI_enable(EUSCI_B0_BASE);

    // Put the welcome message in the transfer buffer
    TXData[TXcount++] = 'L';
    TXData[TXcount++] = 'i';
    TXData[TXcount++] = 'e';
    TXData[TXcount++] = 'b';
    TXData[TXcount++] = 'e';
    TXData[TXcount++] = 'r';
    TXData[TXcount++] = ' ';
    TXData[TXcount++] = 'S';
    TXData[TXcount++] = 'c';
    TXData[TXcount++] = 'h';
    TXData[TXcount++] = 'o';
    TXData[TXcount++] = 'l';
    TXData[TXcount++] = 'l';
    TXData[TXcount++] = 'i';
    TXData[TXcount++] = '!';
    TXData[TXcount++] = ' ';
    TXpointer = TXData;

//    P1OUT &= ~GPIO_PIN4; //  set P1.4 (GPIO3) to L to enable CS
    EUSCI_B_SPI_transmitData(EUSCI_B0_BASE, *TXpointer++);

    EUSCI_B_SPI_enableInterrupt(EUSCI_B0_BASE, EUSCI_B_SPI_RECEIVE_INTERRUPT);

//    __delay_cycles(36000);                           // Delay ~2ms
//    P1OUT |= GPIO_PIN4; //  set P1.4 (GPIO3) to H to disable CS


    // Initialize variables
    adcReady = 0;                                   // Clear ADC ready flag
    command = 0;                                    // Clear command

    // Configure SD24 reference
    SD24CTL = SD24REFS;                             // Internal reference
//    SD24CTL = 0;                                      // External reference
    __delay_cycles(3600);                           // Delay ~200us for 1.2V reference to settle

    // Configure SD24 ADC channels
    SD24INCTL0 |= SD24GAIN_1;                       // Initialize PGA gain for both channels
    SD24INCTL1 |= SD24GAIN_1;
//    SD24CCTL0  |= SD24OSR_256 | SD24GRP;   // OSR = 256, 2's complement
    SD24CCTL0  |= SD24OSR_256 | SD24DF | SD24GRP;   // OSR = 256, 2's complement
    SD24CCTL1  |= SD24OSR_256 | SD24DF | SD24IE;    // Group w/channel A0, enable ADC interrupts
    SD24PRE0 = 0;
    SD24PRE1 = 0;

    // Configure GUI communication
//    GUI_Init();                                                                              // Initialize GUI layer
//    GUI_InitRxCmd( &GUI_RXCommands[0],(sizeof(GUI_RXCommands)/sizeof(GUI_RXCommands[0])) );  // Initialize GUI receive

    // Start ADC conversions
    SD24CCTL1  |= SD24SC;

    // Enable interrupts
    __bis_SR_register(GIE);

    n = 0;
    Vms = 0;
    Ims = 0;
    Pms = 0;
    Vdc = 0;
    Idc = 0;


    // Communication state machine
    while(1)
    {



        // Send ADC data to GUI (when ready)
        if(adcReady == 1)
        {
            voltage = adcA1Data * WIN[n]; // voltage
            current = adcA0Data * WIN[n++]; // current

            // integrate values
            Vdc += voltage;
            Idc += current;
            Vms += voltage * voltage;
            Ims += current * current;
            Pms += voltage * current;

//            n++;

            if (n >= MEASUREMENT_COUNT)
            {

//                P1OUT &= ~GPIO_PIN4; //  set P1.4 (GPIO3) to L to enable CS
// ---------------- calculate Vrms ----------------
                tmpfloat = (Vdc * Vdc) * (WG2/WG1/WG1);
                tmpfloat = Vms - tmpfloat;
                if (tmpfloat > 0.0)
                {
                    Vrms = sqrtf(tmpfloat * (2.0/WG2)) * VSCALE;
                }
                else
                {
                    Vrms = 0.0;
                }

// ---------------- calculate Prms ----------------
                tmpfloat = (Vdc * Idc) * (WG2/WG1/WG1);
                Prms = (Pms  - tmpfloat) * (2.0/WG2 * VSCALE * ISCALE);

// ---------------- calculate Irms ----------------
                tmpfloat = Idc * Idc * (WG2/WG1/WG1);
                tmpfloat = Ims - tmpfloat;
                if (tmpfloat > 0.0)
                {
                    tmpfloat *= (2.0/WG2);
                    if (Prms < PRMSMIN)
                    {
                        Ims0 *= IMS0SCALER;  // increase Ims0 by a constant factor
                    }
                    if (tmpfloat < (Ims0))
                    {
                        Ims0 = tmpfloat;
                    }
                    Irms = sqrtf(tmpfloat - Ims0) * ISCALE;
                }
                else
                {
                    Irms = 0.0;
                }


// ---------------- calculate VArms ----------------
                VArms = Vrms * Irms;

//              P1OUT |= GPIO_PIN4; //  set P1.4 (GPIO3) to H to disable CS


// Output all results
                if (TXcount == 0)
                {
                    // output RMS Voltage
                    // output Vrms
                    TXData[TXcount++] = 'V';
                    TXData[TXcount++] = 'r';
                    TXData[TXcount++] = 'm';
                    TXData[TXcount++] = 's';
                    TXData[TXcount++] = ':';
                    TXData[TXcount++] = ' ';
                    TXcount += float2digits(Vrms, &TXData[TXcount], 5, 2);
                    TXData[TXcount++] = ';';
                    TXData[TXcount++] = ' ';

                    // output RMS Current
                    // output Arms
                    TXData[TXcount++] = 'A';
                    TXData[TXcount++] = 'r';
                    TXData[TXcount++] = 'm';
                    TXData[TXcount++] = 's';
                    TXData[TXcount++] = ':';
                    TXData[TXcount++] = ' ';
                    TXcount += float2digits(Irms, &TXData[TXcount], 5, 3);
                    TXData[TXcount++] = ';';
                    TXData[TXcount++] = ' ';

                    // output Wrms
                    TXData[TXcount++] = 'W';
                    TXData[TXcount++] = 'r';
                    TXData[TXcount++] = 'm';
                    TXData[TXcount++] = 's';
                    TXData[TXcount++] = ':';
                    TXData[TXcount++] = ' ';
                    // output RMS Power
                    TXcount += float2digits(Prms, &TXData[TXcount], 5, 1);
                    TXData[TXcount++] = ';';
                    TXData[TXcount++] = ' ';

                    // output VA Power
                    // output VArms
                    TXData[TXcount++] = 'V';
                    TXData[TXcount++] = 'A';
                    TXData[TXcount++] = 'r';
                    TXData[TXcount++] = 'm';
                    TXData[TXcount++] = 's';
                    TXData[TXcount++] = ':';
                    TXData[TXcount++] = ' ';
                    TXcount += float2digits(VArms, &TXData[TXcount], 5, 1);
                    TXData[TXcount++] = ';';
                    TXData[TXcount++] = ' ';

                    TXpointer = TXData;
                    P1OUT &= ~GPIO_PIN4; //  set P1.4 (GPIO3) to L to enable CS
                    __delay_cycles(36000);                           // Delay ~2ms
                    EUSCI_B_SPI_transmitData(EUSCI_B0_BASE, *TXpointer++);
                }




                n = 0;
                Vms = 0;
                Ims = 0;
                Pms = 0;
                Vdc = 0;
                Idc = 0;
            }
//                GUIComm_sendInt16("0", STR_LEN_ONE, adcA0Data);     // Send A0 ADC data to PC
//                GUIComm_sendInt16("1", STR_LEN_ONE, adcA1Data);     // Send A1 ADC data to PC
            adcReady = 0;                                       // Clear data ready flag
        }
    }
}

#if defined(__TI_COMPILER_VERSION__) || defined(__IAR_SYSTEMS_ICC__)
#pragma vector=SD24_VECTOR
__interrupt void SD24_ISR(void)
#elif defined(__GNUC__)
void __attribute__ ((interrupt(SD24_VECTOR))) SD24_ISR (void)
#else
#error Compiler not supported!
#endif
{
     int16_t a0, a1;
     uint16_t b0, b1;

    switch (__even_in_range(SD24IV,SD24IV_SD24MEM3)) {
        case SD24IV_NONE: break;
        case SD24IV_SD24OVIFG: break;
        case SD24IV_SD24MEM0: break;
        case SD24IV_SD24MEM1:
            SD24CCTL0 &= ~SD24LSBACC;
            SD24CCTL1 &= ~SD24LSBACC;
            a0 = SD24MEM0; // higher word
            a1 = SD24MEM1; // higher word
            // switch to LSB access
            SD24CCTL0 |= SD24LSBACC;
            SD24CCTL1 |= SD24LSBACC;
            b0 = SD24MEM0; // lower word
            b1 = SD24MEM1; // lower word

            adcA0Data = (uint32_t)a0 << 8;
            adcA0Data += b0 & 0x00ff;       // Save CH0 results

            adcA1Data = (uint32_t)a1 << 8;
            adcA1Data += b1 & 0x00ff;       // Save CH1 results (clears IFG)

            adcReady = 1;                           // Set data ready flag
            break;
        case SD24IV_SD24MEM2: break;
        case SD24IV_SD24MEM3: break;
        default: break;
    }
}

#if defined(__TI_COMPILER_VERSION__) || defined(__IAR_SYSTEMS_ICC__)
#pragma vector=USCI_B0_VECTOR
__interrupt
#elif defined(__GNUC__)
__attribute__((interrupt(USCI_B0_VECTOR)))
#endif
void USCI_B0_ISR(void)
{
    switch(__even_in_range(UCB0IV, USCI_SPI_UCTXIFG))
    {
        case USCI_NONE: break;
        case USCI_SPI_UCRXIFG:
                        // Read what slave sent. Should be same as transferred. If there
                        // is a mismatch turn on the LED
                        RXData = EUSCI_B_SPI_receiveData(EUSCI_B0_BASE);

                        if (--TXcount > 0)
                        {
                            EUSCI_B_SPI_transmitData(EUSCI_B0_BASE, *TXpointer++);
                        }
                        else
                        {
                            P1OUT |= GPIO_PIN4; //  set P1.4 (GPIO3) to H to disable CS
                        }
                        break;
        case USCI_SPI_UCTXIFG:
            break;
        default: break;
    }
}
