jrmfrbg/7SegmentWattageCounterESP32/MSP430_software/GPIO.c

//*****************************************************************************
//
// gpio.c - Driver for the gpio Module.
//
//*****************************************************************************

//*****************************************************************************
//
//! \addtogroup gpio_api gpio
//! @{
//
//*****************************************************************************

#include "hw_memmap.h"

#if defined(__MSP430_HAS_PORT1__) || defined(__MSP430_HAS_PORT2__)
#include "gpio.h"

#include <assert.h>

static const uint16_t GPIO_PORT_TO_BASE[] = {
    0x00,
#if defined(__MSP430_HAS_PORT1_R__)
    __MSP430_BASEADDRESS_PORT1_R__,
#elif defined(__MSP430_HAS_PORT1__)
    __MSP430_BASEADDRESS_PORT1__,
#else
    0xFFFF,
#endif
#if defined(__MSP430_HAS_PORT2_R__)
    __MSP430_BASEADDRESS_PORT2_R__,
#elif defined(__MSP430_HAS_PORT2__)
    __MSP430_BASEADDRESS_PORT2__,
#else
    0xFFFF,
#endif
#if defined(__MSP430_HAS_PORT3_R__)
    __MSP430_BASEADDRESS_PORT3_R__,
#elif defined(__MSP430_HAS_PORT3__)
    __MSP430_BASEADDRESS_PORT3__,
#else
    0xFFFF,
#endif
#if defined(__MSP430_HAS_PORT4_R__)
    __MSP430_BASEADDRESS_PORT4_R__,
#elif defined(__MSP430_HAS_PORT4__)
    __MSP430_BASEADDRESS_PORT4__,
#else
    0xFFFF,
#endif
#if defined(__MSP430_HAS_PORT5_R__)
    __MSP430_BASEADDRESS_PORT5_R__,
#elif defined(__MSP430_HAS_PORT5__)
    __MSP430_BASEADDRESS_PORT5__,
#else
    0xFFFF,
#endif
#if defined(__MSP430_HAS_PORT6_R__)
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
    }

    HWREG16(baseAddress + OFS_PAIE) &= ~selectedPins;
}

uint16_t GPIO_getInterruptStatus(uint8_t selectedPort, uint16_t selectedPins) {

    uint16_t baseAddress = GPIO_PORT_TO_BASE[selectedPort];

    #ifndef NDEBUG
    if(baseAddress == 0xFFFF) {
        return;
    }
    #endif

    // Shift by 8 if port is even (upper 8-bits)
    if((selectedPort & 1) ^ 1) {
        if((baseAddress & 0x1) ^ 0x1)
        {
            return (HWREG8(baseAddress + OFS_PAIFG_H) & selectedPins);
        }
        else
        {
            return (HWREG8(baseAddress + OFS_PAIFG) & selectedPins);
        }
    }
    else {
        return (HWREG16(baseAddress + OFS_PAIFG) & selectedPins);
    }
}

void GPIO_clearInterrupt(uint8_t selectedPort, uint16_t selectedPins) {

    uint16_t baseAddress = GPIO_PORT_TO_BASE[selectedPort];

    #ifndef NDEBUG
    if(baseAddress == 0xFFFF) {
        return;
    }
    #endif

    // Shift by 8 if port is even (upper 8-bits)
    if((selectedPort & 1) ^ 1) {
        selectedPins <<= 8;
    }

    HWREG16(baseAddress + OFS_PAIFG) &= ~selectedPins;
}

void GPIO_selectInterruptEdge(uint8_t selectedPort, uint16_t selectedPins,
                                   uint8_t edgeSelect) {

    uint16_t baseAddress = GPIO_PORT_TO_BASE[selectedPort];

    #ifndef NDEBUG
    if(baseAddress == 0xFFFF) {
        return;
    }
    #endif

    // Shift by 8 if port is even (upper 8-bits)
    if((selectedPort & 1) ^ 1) {
        selectedPins <<= 8;
    }

    if (GPIO_LOW_TO_HIGH_TRANSITION == edgeSelect){
        HWREG16(baseAddress + OFS_PAIES) &= ~selectedPins;
    }
    else {
        HWREG16(baseAddress + OFS_PAIES) |= selectedPins;
    }
}


#endif
//*****************************************************************************
//
//! Close the doxygen group for gpio_api
//! @}
//
//*****************************************************************************
