jrmfrbg/7SegmentWattageCounterESP32/MSP430_software/hann_window.h

/* Automatic generated file. Do not change. 
 * 
 * hann_window.h
 * 
 * Author: ihma
 */

#define MEASUREMENT_COUNT  1965   // number of samples per measurement  for 0.5 s frames.

#define WG1 9.82000000e+02
#define WG2 7.36500000e+02
const float WIN[MEASUREMENT_COUNT] =
{
  0.00000000e+00,
  2.55868255e-06,
  1.02347040e-05,
  2.30279859e-05,
  4.09383971e-05,
  6.39657545e-05,
  9.21098223e-05,
  1.25370313e-04,
  1.63746885e-04,
  2.07239146e-04,
  2.55846652e-04,
  3.09568904e-04,
  3.68405352e-04,
  4.32355396e-04,
  5.01418379e-04,
  5.75593596e-04,
  6.54880287e-04,
  7.39277640e-04,
  8.28784792e-04,
  9.23400827e-04,
  1.02312478e-03,
  1.12795562e-03,
  1.23789228e-03,
  1.35293364e-03,
  1.47307852e-03,
  1.59832569e-03,
  1.72867386e-03,
  1.86412170e-03,
  2.00466784e-03,
  2.15031081e-03,
  2.30104915e-03,
  2.45688130e-03,
  2.61780567e-03,
  2.78382062e-03,
  2.95492443e-03,
  3.13111537e-03,
  3.31239163e-03,
  3.49875135e-03,
  3.69019263e-03,
  3.88671351e-03,
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
};
