jrmfrbg/7SegmentWattageCounterESP32/MSP430_software/IO_functions.h

/*
 * IO_functions.h
 *
 *  Created on: 18.04.2025
 *      Author: ihma
 */
#include "stdint.h"

#ifndef IO_FUNCTIONS_H_
#define IO_FUNCTIONS_H_

extern uint8_t float2digits(float value, char* txt, int8_t digits, int8_t decimals);


#endif /* IO_FUNCTIONS_H_ */
