jrmfrbg/7SegmentWattageCounterESP32/(commit log)

2025-03-21 added wattage Counter for slaveGesammteLeistung
    added functionality to keep track of how many watts where used since slaveGesammteLeistung was turned on.
    There is sill a function in the code to display the total wattage using a LED, will remove later...
2025-03-21 added slaveAktuelleLeistung, still problems with calculation of watt/h, need to fix later
    [Master.ino, slaveGesammteLeistung.ino]
2025-03-22 added startup LED patterns to identify esp functionality on startup
2025-03-22 fixed problem with slaveAktuelleLeistung only showing wrong data
    [slaveAktuelleLeistung.ino]
2025-03-22 added functionality to use the last 3 registered watts to calculate current wattage, smothes out results
2025-03-22 selection table added
    Excel-sheet with different realizations and prize estimations
    [Selection of Realization.xlsx]
2025-03-26 fixed bugs, added dimming functionality for slaves using fototransistors on pin 0
    [Master.ino, slaveAktuelleLeistung.ino, slaveGesammteLeistung.ino]
2025-03-27 draft version of the schematic added
2025-03-29 Schematic and PCB-Layout put under version control
    [AC-Power-Monitor.PrjPcb, AC-Power-Monitor.SchDoc]
2025-03-29 optimized component placement
    [AC-Power-Monitor.PrjPcb, AC-Power-Monitor.SchDoc]
2025-04-01 Routing finished
    [AC-Power-Monitor.PrjPcb, AC-Power-Monitor.SchDoc]
2025-04-02 adjust standoff-holes; create draftsman
    [AC-Power-Monitor.PrjPcb, AC-Power-Monitor.SchDoc]
2025-04-02 standoff-holes now finally fixed
2025-04-02 Connector for ESP32 flipped
    [AC-Power-Monitor.SchDoc]
2025-04-06 final data for A1 production
    [AC-Power-Monitor.PcbDoc, AC-Power-Monitor.SchDoc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]
2025-04-06 Documentation file with BOM added
    [AC-Power-Monitor.PrjPcb, AC-Power-Monitor.SchDoc]
2025-04-20 update of documentation for AC-Power Meter Board
2025-04-26 updated master.ino to add functionality for communication between ESP32 and msp430
2025-05-07 fixed problems with multiple digits for display driver
    [Master.ino, slaveGesammteLeistung.ino]
2025-05-09 fixed many problems. V1
    [Master.ino, slaveAktuelleLeistung.ino, slaveGesammteLeistung.ino]
2025-05-18 add Output files (Gerber, Drill, Video)
2025-05-18 add patches to schematic
    [AC-Power-Monitor.PcbDoc, AC-Power-Monitor.SchDoc]
2025-05-24 MSP430 Software: individual scaling factors for devices #0001 to #0005 added
2025-05-30 BOM update
